jwidess/ARGB-WLED-PC-Controller/Devboard/README.md

# Devboard

This devboard was a quick perfboard design to get WLED running and driving my ARGB fans. The design has a handful of problems listed below.

  1. The ["BOB-12009" Level Shifter is not recommended](https://kno.wled.ge/basics/compatible-hardware/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.) due to the slow pull up nature of the design. Using a SN74AHCT125 bus buffer is a better approach.
  2. A 62-100Ohm resistor should be used on the outputs to the data pins of the 3-pin ARGB connectors.
  3. Each 3-pin ARGB connector could benefit from a ~100nF decoupling cap near its terminals. 
  4. No reverse polarity protection. Not a huge deal, but for a DIY device, would be nice.

Example Image

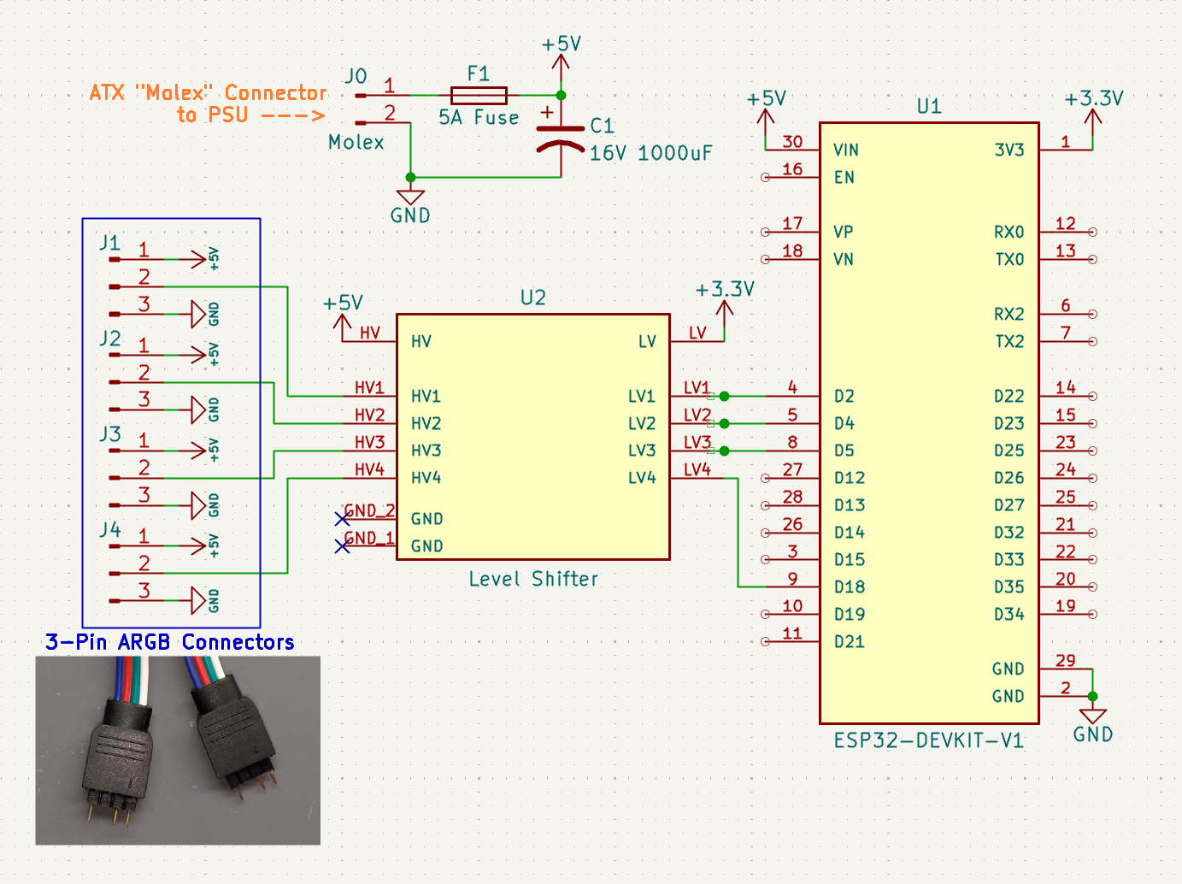
[picture p2: Devboard/Devboard-Schematic.png]
Schematic


## Parts List
1. [ElectroCookie](https://www.amazon.com/ElectroCookie-Prototype-Snappable-Electronics-Gold-Plated/dp/B081R4YBY7) Perfboards
2. ESP32 (Whatever module or devboard you'd like)
3. Either an ATX "Molex" connector or a SATA Power connector to provide power.
4. 3-pin ARGB Connectors (I modified 4-pin connectors)
