jwidess/ARGB-WLED-PC-Controller/Devboard/Case 3D Models/Case V2(v7).stl

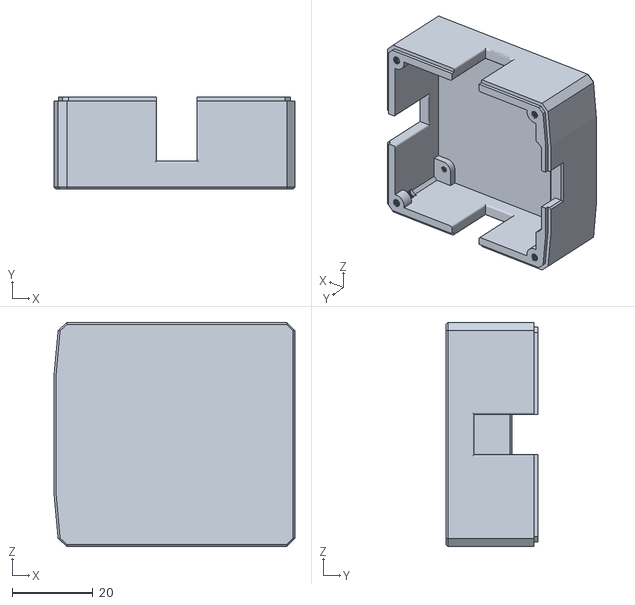
[picture p3: CAD file, 2025-08-23]
Devboard/Case 3D Models/Case V2(v7).stl
59.7 x 22.8 x 55.5
