jwidess/ARGB-WLED-PC-Controller/Devboard/KiCad Library/BOB-12009/BOB-12009.step

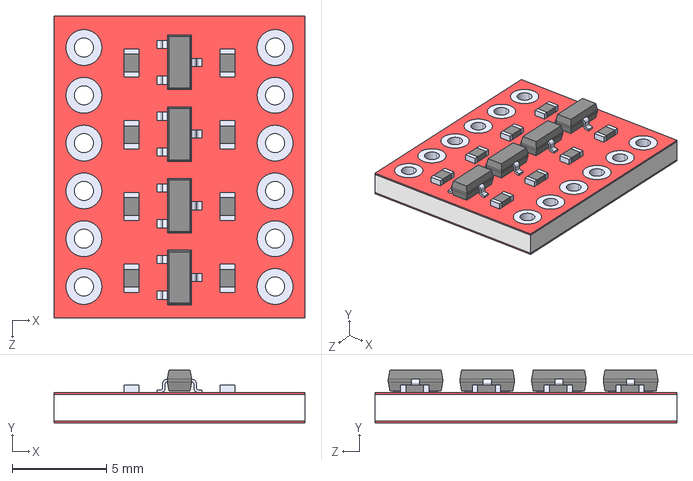
[picture p4: CAD file, 2025-08-23]
Devboard/KiCad Library/BOB-12009/BOB-12009.step
13.3 x 2.80 x 16.1 mm
