jwidess/ARGB-WLED-PC-Controller/Devboard/Case 3D Models/Lid V2(v7).stl

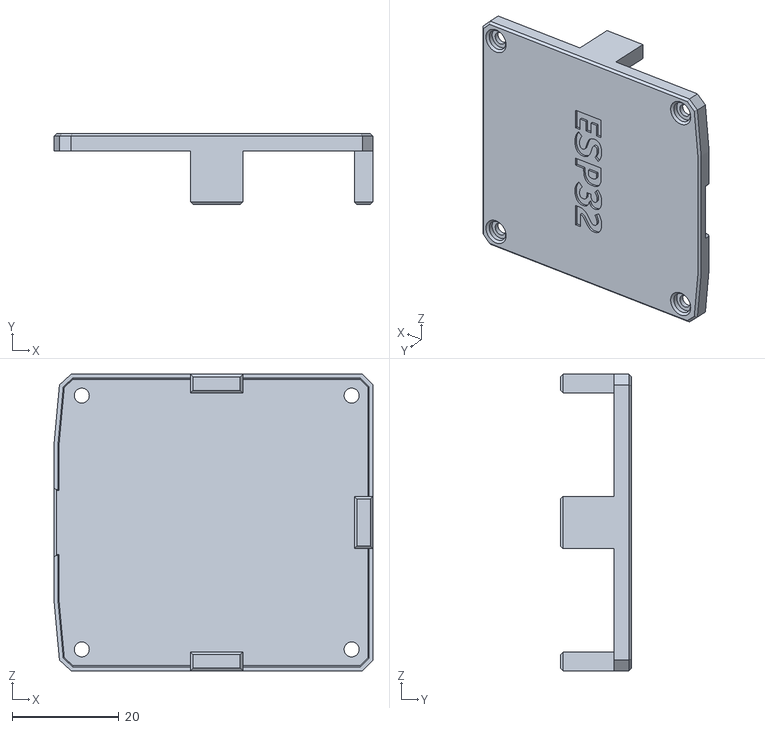
[picture p5: CAD file, 2025-08-23]
Devboard/Case 3D Models/Lid V2(v7).stl
59.7 x 13.3 x 55.5
