jwidess/ARGB-WLED-PC-Controller/Devboard/ARGB-WLED-Controller-Devboard-Mk1/ARGB-WLED-Controller-Devboard-Mk1.kicad_sch

## KiCad design Devboard/ARGB-WLED-Controller-Devboard-Mk1/ARGB-WLED-Controller-Devboard-Mk1.kicad_sch (2025-08-23)

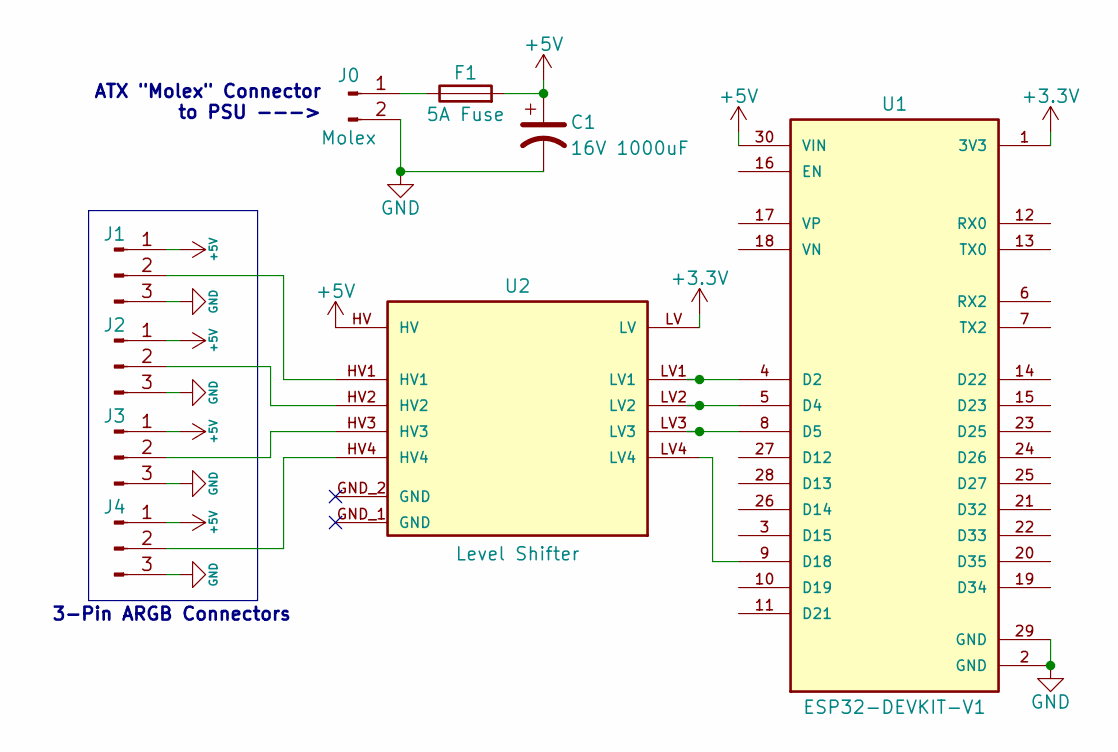
[picture p6: schematic ARGB-WLED-Controller-Devboard-Mk1.kicad_sch]

Parts:
C1: 16V 1000uF
F1: 5A Fuse
J0: Molex
J1, J2, J3, J4: ARGB 3-Pin
U1: ESP32-DEVKIT-V1; MODULE_ESP32_DEVKIT_V1; PARTREV N/A
U2: Level Shifter; CONV_BOB-12009; PARTREV 01

Connections:
+3.3V: U1.1 (3V3), U2.LV
+5V: C1.1, F1.2, J1.1, J2.1, J3.1, J4.1, U1.30 (VIN), U2.HV
GND: C1.2, J0.2, J1.3, J2.3, J3.3, J4.3, U1.2 (GND), U1.29 (GND)
unnamed: F1.1, J0.1
unnamed: J1.2, U2.HV1
unnamed: J2.2, U2.HV2
unnamed: J3.2, U2.HV3
unnamed: J4.2, U2.HV4
unnamed: U1.4 (D2), U2.LV1
unnamed: U1.5 (D4), U2.LV2
unnamed: U1.8 (D5), U2.LV3
unnamed: U1.9 (D18), U2.LV4

Notes on the sheet:
3-Pin ARGB Connectors
ATX "Molex" Connector to PSU --->
