jwidess/ARGB-WLED-PC-Controller/(commit log)

2025-08-23 Added devboard schematic
    Added the devboard KiCad schematic
    [ARGB-WLED-Controller-Devboard-Mk1.kicad_pcb, ARGB-WLED-Controller-Devboard-Mk1.kicad_sch, BOB-12009.step]
2025-08-23 Added case 3D Models
    [Case V2(v7).stl, Lid V2(v7).stl]
